icl-rocketry/Ricardo-Heimdall/README.md

Need to add v monitoring to include the buck stuff from chad
Need to add 6v led to know when servo voltage is on
