icl-rocketry/Ricardo-Heimdall/Hardware/Heimdall.kicad_pcb

## KiCad design Hardware/Heimdall.kicad_pcb (2026-07-14)

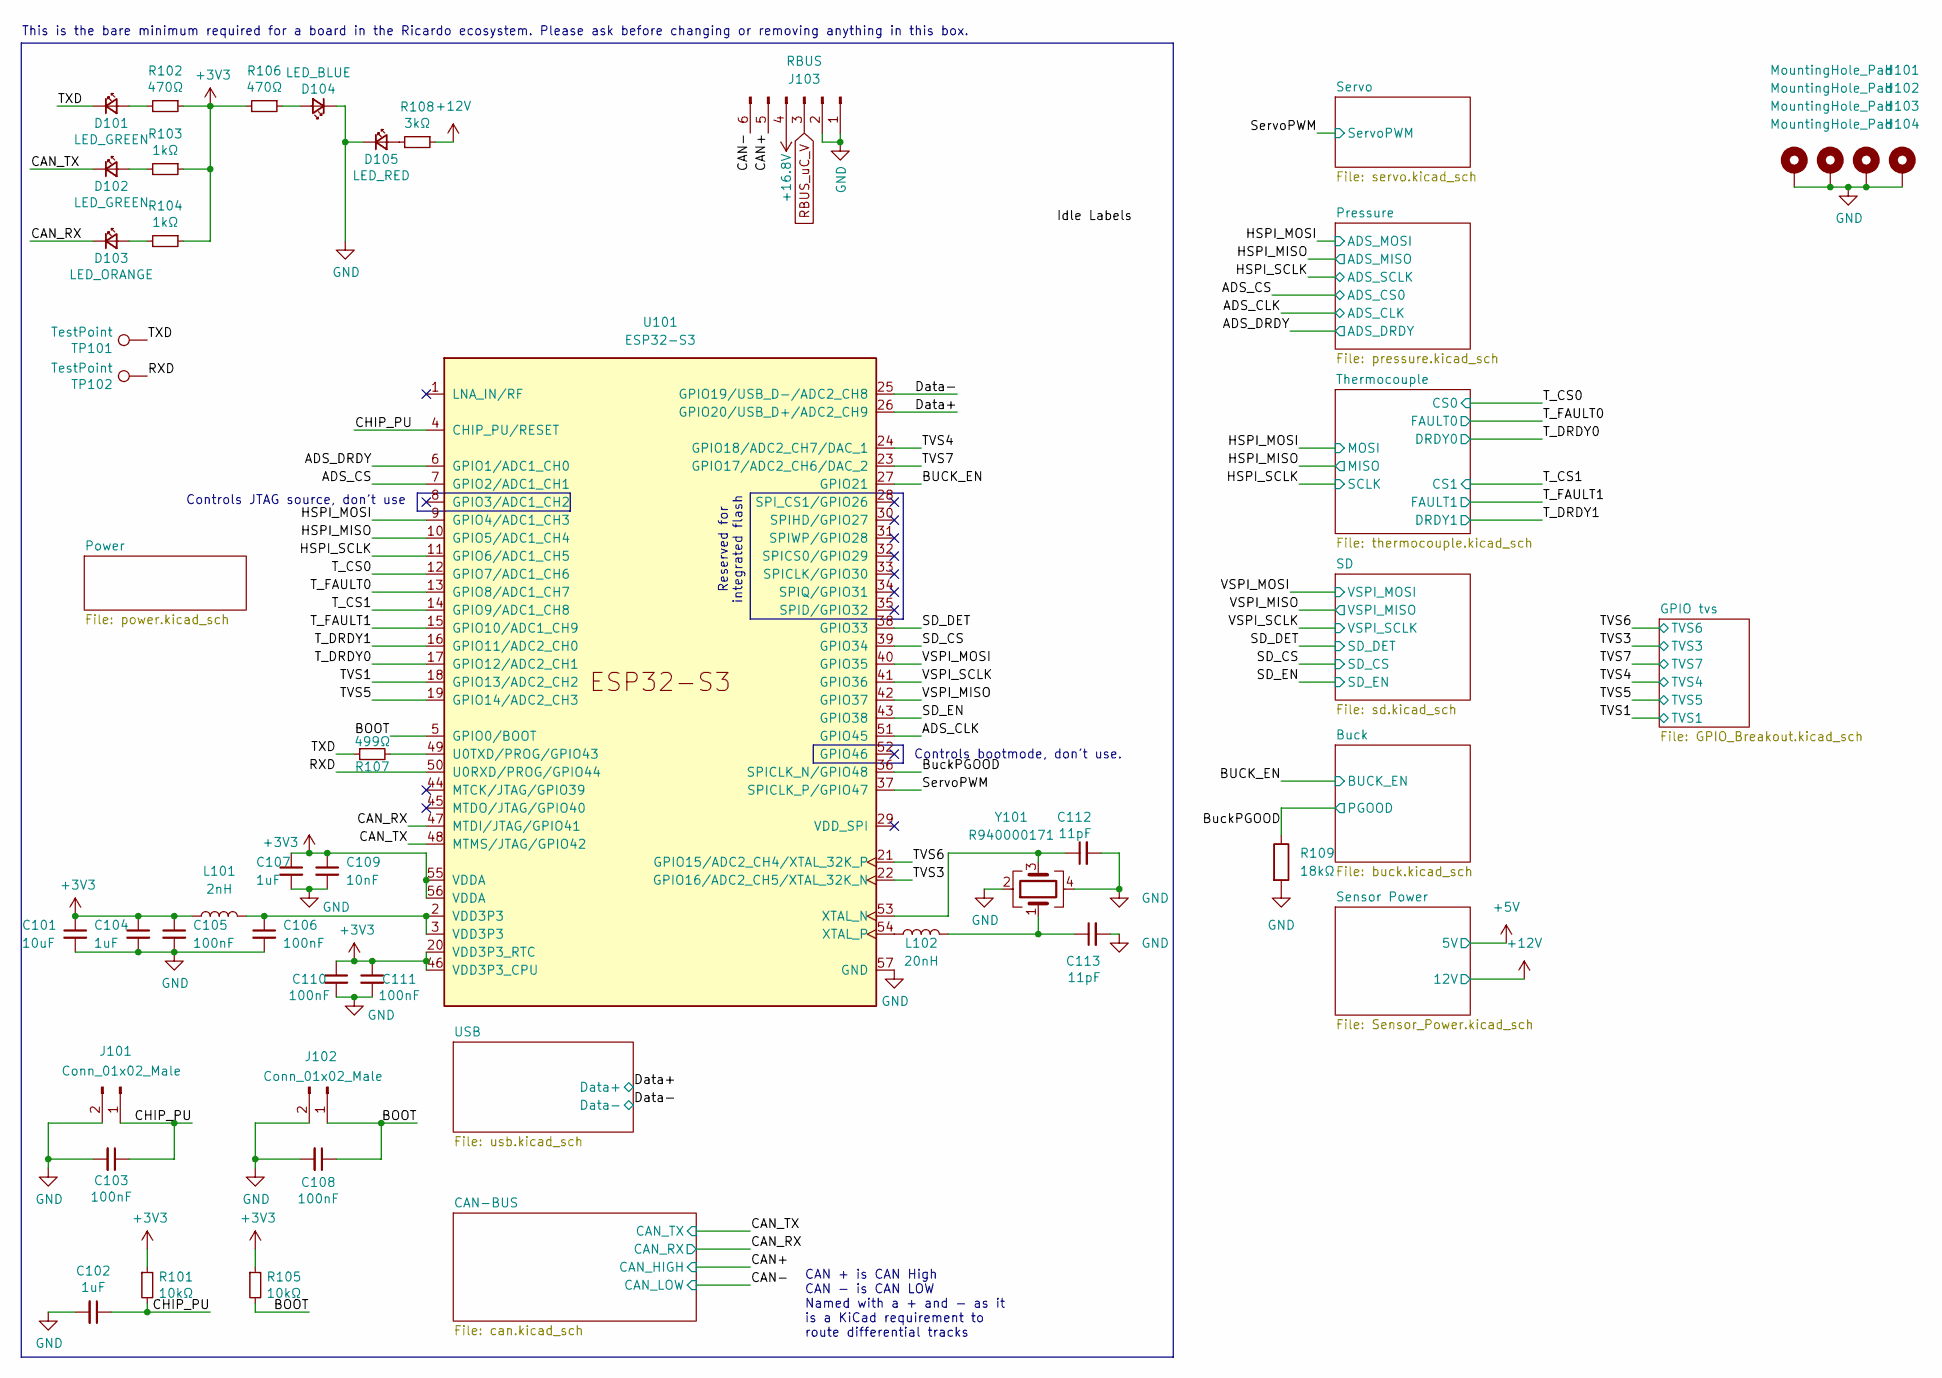
[picture p1: schematic Heimdall.kicad_sch]

Parts:
C101: 10uF; C_0402_1005Metric
C102, C104, C107: 1uF; C_0402_1005Metric
C103, C105, C106, C108, C110, C111: 100nF; C_0402_1005Metric
C109: 10nF; C_0402_1005Metric
C112, C113: 11pF; C_0402_1005Metric
D101, D102: LED_GREEN; LED_0402_1005Metric
D103: LED_ORANGE; LED_0402_1005Metric
D104: LED_BLUE; LED_0402_1005Metric
D105: LED_RED; LED_0402_1005Metric
H101, H102, H103, H104: MountingHole_Pad; MountingHole_3.2mm_M3_DIN965_Pad
J101, J102: Conn_01x02_Male; PinHeader_1x02_P2.54mm_Vertical
J103: RBUS; Molex_Mini-Fit_Jr_5569-06A2_2x03_P4.20mm_Horizontal
L101: 2nH; L_0402_1005Metric
L102: 20nH; L_0402_1005Metric
R101, R105: 10kΩ; R_0402_1005Metric
R102, R106: 470Ω; R_0402_1005Metric
R103, R104: 1kΩ; R_0402_1005Metric
R107: 499Ω; R_0402_1005Metric
R108: 3kΩ; R_0402_1005Metric
R109: 18kΩ; R_0402_1005Metric
TP101, TP102: TestPoint; TestPoint_Pad_D1.0mm
U101: ESP32-S3; QFN40P700X700X90-57N
Y101: R940000171; Crystal_SMD_2016-4Pin_2.0x1.6mm

Connections:
+3V3: C101.1, C104.1, C105.1, C107.1, C109.1, C110.1, C111.1, L101.1, R101.1, R102.1, R103.1, R104.1, R105.1, R106.2, U101.20 (VDD3P3_RTC), U101.46 (VDD3P3_CPU), U101.55 (VDDA), U101.56 (VDDA); also elsewhere on the board
+12V: R108.1; also elsewhere on the board
+16.8V: J103.4; also elsewhere on the board
/ADS_CLK: U101.51 (GPIO45); also elsewhere on the board
/ADS_CS: U101.7 (GPIO2/ADC1_CH1); also elsewhere on the board
/ADS_DRDY: U101.6 (GPIO1/ADC1_CH0); also elsewhere on the board
/BOOT: C108.1, J102.1, R105.2, U101.5 (GPIO0/BOOT)
/BUCK_EN: U101.27 (GPIO21); also elsewhere on the board
/BuckPGOOD: R109.1, U101.36 (SPICLK_N/GPIO48); also elsewhere on the board
/CAN+: J103.5; also elsewhere on the board
/CAN-: J103.6; also elsewhere on the board
/CAN_RX: D103.1 (K), U101.47 (MTDI/JTAG/GPIO41); also elsewhere on the board
/CAN_TX: D102.1 (K), U101.48 (MTMS/JTAG/GPIO42); also elsewhere on the board
/CHIP_PU: C102.1, C103.1, J101.1, R101.2, U101.4 (CHIP_PU/RESET)
/Data+: U101.26 (GPIO20/USB_D+/ADC2_CH9); also elsewhere on the board
/Data-: U101.25 (GPIO19/USB_D-/ADC2_CH8); also elsewhere on the board
/HSPI_MISO: U101.10 (GPIO5/ADC1_CH4); also elsewhere on the board
/HSPI_MOSI: U101.9 (GPIO4/ADC1_CH3); also elsewhere on the board
/HSPI_SCLK: U101.11 (GPIO6/ADC1_CH5); also elsewhere on the board
/RXD: TP102.1, U101.50 (U0RXD/PROG/GPIO44)
/SD_CS: U101.39 (GPIO34); also elsewhere on the board
/SD_DET: U101.38 (GPIO33); also elsewhere on the board
/SD_EN: U101.43 (GPIO38); also elsewhere on the board
/ServoPWM: U101.37 (SPICLK_P/GPIO47); also elsewhere on the board
/TVS1: U101.18 (GPIO13/ADC2_CH2); also elsewhere on the board
/TVS3: U101.22 (GPIO16/ADC2_CH5/XTAL_32K_N); also elsewhere on the board
/TVS4: U101.24 (GPIO18/ADC2_CH7/DAC_1); also elsewhere on the board
/TVS5: U101.19 (GPIO14/ADC2_CH3); also elsewhere on the board
/TVS6: U101.21 (GPIO15/ADC2_CH4/XTAL_32K_P); also elsewhere on the board
/TVS7: U101.23 (GPIO17/ADC2_CH6/DAC_2); also elsewhere on the board
/TXD: D101.1 (K), R107.1, TP101.1
/T_CS0: U101.12 (GPIO7/ADC1_CH6); also elsewhere on the board
/T_CS1: U101.14 (GPIO9/ADC1_CH8); also elsewhere on the board
/T_DRDY0: U101.17 (GPIO12/ADC2_CH1); also elsewhere on the board
/T_DRDY1: U101.16 (GPIO11/ADC2_CH0); also elsewhere on the board
/T_FAULT0: U101.13 (GPIO8/ADC1_CH7); also elsewhere on the board
/T_FAULT1: U101.15 (GPIO10/ADC1_CH9); also elsewhere on the board
/VSPI_MISO: U101.42 (GPIO37); also elsewhere on the board
/VSPI_MOSI: U101.40 (GPIO35); also elsewhere on the board
/VSPI_SCLK: U101.41 (GPIO36); also elsewhere on the board
GND: C101.2, C102.2, C103.2, C104.2, C105.2, C106.2, C107.2, C108.2, C109.2, C110.2, C111.2, C112.2, C113.2, D104.1 (K), D105.1 (K), H101.1, H102.1, H103.1, H104.1, J101.2, J102.2, J103.1, J103.2, R109.2, U101.57 (GND), Y101.2, Y101.4; also elsewhere on the board
unnamed: C106.1, L101.2, U101.2 (VDD3P3), U101.3 (VDD3P3)
unnamed: C113.1, L102.2, Y101.1
unnamed: D101.2 (A), R102.2
unnamed: D102.2 (A), R103.2
unnamed: D103.2 (A), R104.2
unnamed: D104.2 (A), R106.1
unnamed: D105.2 (A), R108.2
unnamed: R107.2, U101.49 (U0TXD/PROG/GPIO43)
unnamed: C112.1, U101.53 (XTAL_N), Y101.3
unnamed: L102.1, U101.54 (XTAL_P)
RBUS_uC_V: J103.3; also elsewhere on the board

Notes on the sheet:
Controls bootmode, don't use.
This is the bare minimum required for a board in the Ricardo ecosystem. Please ask before changing or removing anything in this box.
CAN + is CAN High CAN - is CAN LOW Named with a + and - as it is a KiCad requirement to route differential tracks
Controls JTAG source, don't use
Reserved for integrated flash

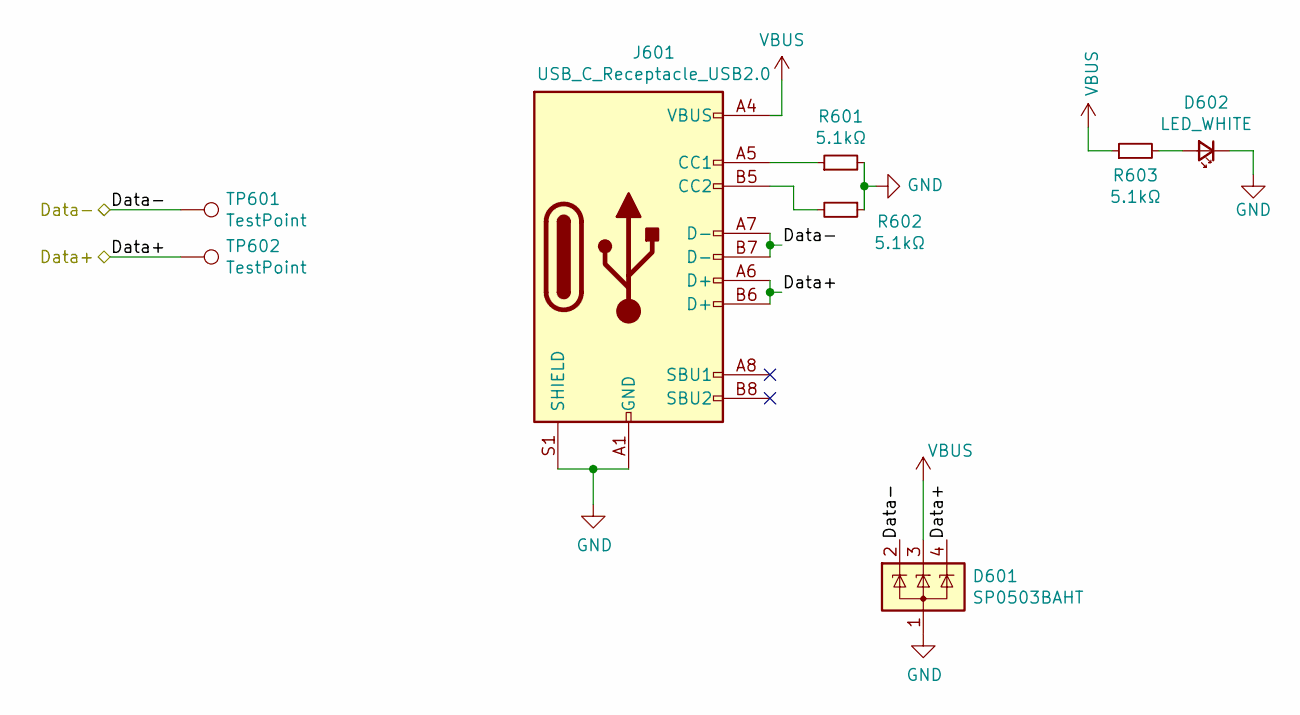
[picture p2: schematic usb.kicad_sch]

Parts:
D601: SP0503BAHT; SOT-143
D602: LED_WHITE; LED_0402_1005Metric
J601: USB_C_Receptacle_USB2.0; USB_C_Receptacle_Palconn_UTC16-G
R601, R602, R603: 5.1kΩ; R_0402_1005Metric
TP601, TP602: TestPoint; TestPoint_Pad_D1.0mm

Connections:
/Data+: D601.4 (K), J601.A6 (D+), J601.B6 (D+), TP602.1; also elsewhere on the board
/Data-: D601.2 (K), J601.A7 (D-), J601.B7 (D-), TP601.1; also elsewhere on the board
GND: D601.1 (A), D602.1 (K), J601.A1 (GND), J601.A12 (GND), J601.B1 (GND), J601.B12 (GND), J601.S1 (SHIELD), R601.2, R602.1; also elsewhere on the board
unnamed: D602.2 (A), R603.2
unnamed: J601.A5 (CC1), R601.1
unnamed: J601.B5 (CC2), R602.2
VBUS: D601.3 (K), J601.A4 (VBUS), J601.A9 (VBUS), J601.B4 (VBUS), J601.B9 (VBUS), R603.1; also elsewhere on the board

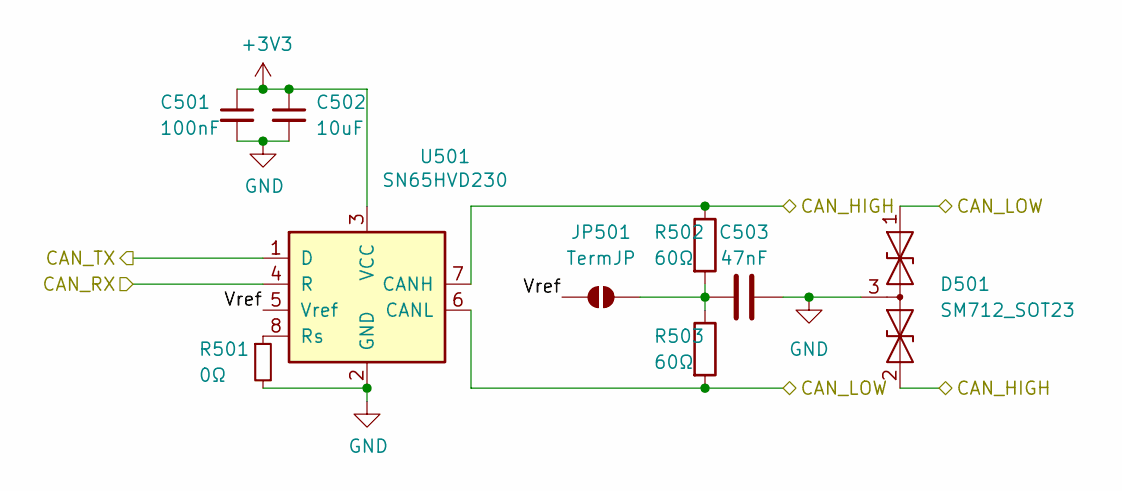
[picture p3: schematic can.kicad_sch]

Parts:
C501: 100nF; C_0402_1005Metric
C502: 10uF; C_0402_1005Metric
C503: 47nF; C_0402_1005Metric
D501: SM712_SOT23; SOT-23
JP501: TermJP; SmallerSolderJP
R501: 0Ω; R_0402_1005Metric
R502, R503: 60Ω; R_0603_1608Metric
U501: SN65HVD230; SOIC-8_3.9x4.9mm_P1.27mm

Connections:
+3V3: C501.1, C502.1, U501.3 (VCC); also elsewhere on the board
/CAN+: D501.2 (A2), R502.1, U501.7 (CANH); also elsewhere on the board
/CAN-: D501.1 (A1), R503.2, U501.6 (CANL); also elsewhere on the board
/CAN-BUS/Vref: JP501.1 (A), U501.5 (Vref)
/CAN_RX: U501.4 (R); also elsewhere on the board
/CAN_TX: U501.1 (D); also elsewhere on the board
GND: C501.2, C502.2, C503.2, D501.3 (common), R501.2, U501.2 (GND); also elsewhere on the board
unnamed: C503.1, JP501.2 (B), R502.2, R503.1
unnamed: R501.1, U501.8 (Rs)

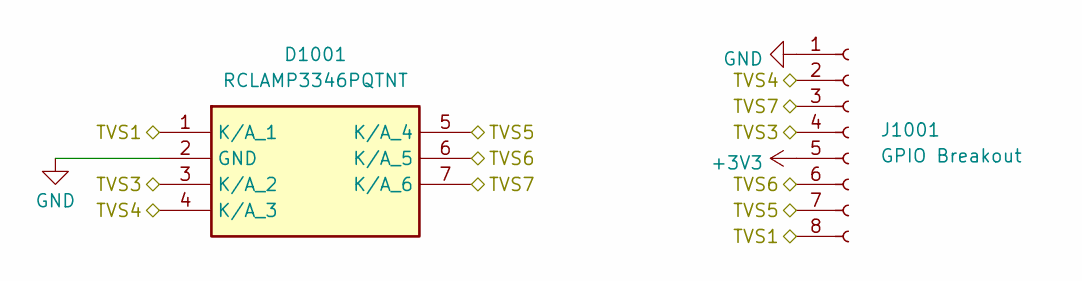
[picture p4: schematic GPIO_Breakout.kicad_sch]

Parts:
D1001: RCLAMP3346PQTNT; Mouser Part Number 947-RCLAMP3346PQTNT
J1001: GPIO Breakout; PinSocket_2x04_P2.54mm_Vertical

Connections:
+3V3: J1001.5; also elsewhere on the board
/TVS1: D1001.1 (K/A_1), J1001.8; also elsewhere on the board
/TVS3: D1001.3 (K/A_2), J1001.4; also elsewhere on the board
/TVS4: D1001.4 (K/A_3), J1001.2; also elsewhere on the board
/TVS5: D1001.5 (K/A_4), J1001.7; also elsewhere on the board
/TVS6: D1001.6 (K/A_5), J1001.6; also elsewhere on the board
/TVS7: D1001.7 (K/A_6), J1001.3; also elsewhere on the board
GND: D1001.2 (GND), J1001.1; also elsewhere on the board

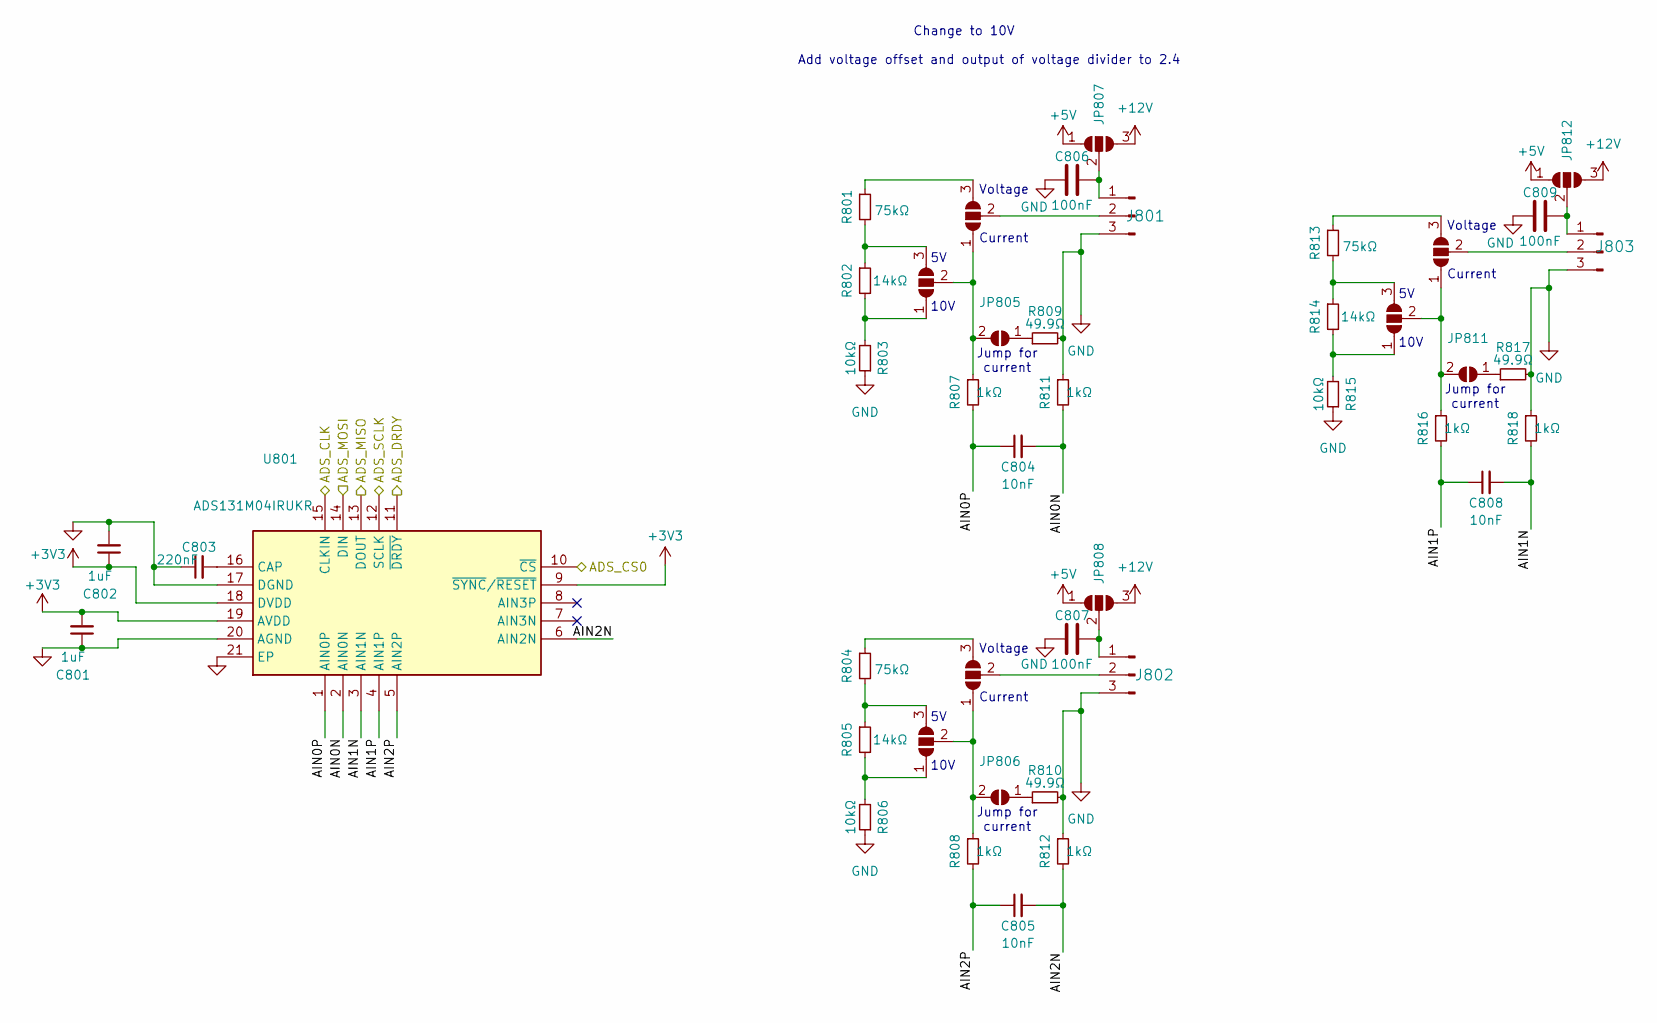
[picture p5: schematic pressure.kicad_sch]

Parts:
C801, C802: 1uF; C_0402_1005Metric
C803: 220nF; C_0402_1005Metric
C804, C805, C808: 10nF; C_0402_1005Metric
C806, C807, C809: 100nF; C_0402_1005Metric
J801, J802, J803: 1053131103; Molex_Nano-Fit_105313-xx03_1x03_P2.50mm_Horizontal
JP801, JP802, JP803, JP804, JP807, JP808, JP809, JP810, JP812: SolderJumper_3_Open; SolderJumper-3_P1.3mm_Open_RoundedPad1.0x1.5mm_NumberLabels
JP805, JP806, JP811: SolderJumper_2_Open; SmallerSolderJP
R801, R804, R813: 75kΩ; R_0402_1005Metric; MPN RT0402BRD0775KL
R802, R805, R814: 14kΩ; R_0402_1005Metric; MPN 0402WGF1402TCE
R803, R806, R815: 10kΩ; R_0402_1005Metric; MPN ERA2ARB103X
R807, R808, R811, R812, R816, R818: 1kΩ; R_0402_1005Metric
R809, R810, R817: 49.9Ω; R_0402_1005Metric; MPN RT0402BRD0749R9L
U801: ADS131M04IRUKR; QFN40P300X300X80-21N-D; Manufacturer_Part_Number ADS131M04IRUKR; Mouser Part Number 595-ADS131M04IRUKR

Connections:
+3V3: C801.2, C802.1, U801.9 (~SYNC/~RESET), U801.18 (DVDD), U801.19 (AVDD); also elsewhere on the board
+5V: JP807.1 (A), JP808.1 (A), JP812.1 (A); also elsewhere on the board
+12V: JP807.3 (B), JP808.3 (B), JP812.3 (B); also elsewhere on the board
/ADS_CLK: U801.15 (CLKIN); also elsewhere on the board
/ADS_CS: U801.10 (~CS); also elsewhere on the board
/ADS_DRDY: U801.11 (~DRDY); also elsewhere on the board
/HSPI_MISO: U801.13 (DOUT); also elsewhere on the board
/HSPI_MOSI: U801.14 (DIN); also elsewhere on the board
/HSPI_SCLK: U801.12 (SCLK); also elsewhere on the board
/Pressure/AIN0N: C804.2, R811.2, U801.2 (AIN0N)
/Pressure/AIN0P: C804.1, R807.2, U801.1 (AIN0P)
/Pressure/AIN1N: C808.2, R818.2, U801.3 (AIN1N)
/Pressure/AIN1P: C808.1, R816.2, U801.4 (AIN1P)
/Pressure/AIN2N: C805.2, R812.2, U801.6 (AIN2N)
/Pressure/AIN2P: C805.1, R808.2, U801.5 (AIN2P)
GND: C801.1, C802.2, C803.1, C806.1, C807.1, C809.1, J801.3, J802.3, J803.3, R803.1, R806.1, R809.2, R810.2, R811.1, R812.1, R815.1, R817.2, R818.1, U801.17 (DGND), U801.20 (AGND), U801.21 (EP); also elsewhere on the board
unnamed: C806.2, J801.1, JP807.2 (C)
unnamed: J801.2, JP803.2 (C)
unnamed: C807.2, J802.1, JP808.2 (C)
unnamed: J802.2, JP804.2 (C)
unnamed: C809.2, J803.1, JP812.2 (C)
unnamed: J803.2, JP810.2 (C)
unnamed: JP801.1 (A), R802.2, R803.2
unnamed: JP801.3 (B), R801.2, R802.1
unnamed: JP801.2 (C), JP803.1 (A), JP805.2 (B), R807.1
unnamed: JP802.1 (A), R805.2, R806.2
unnamed: JP802.3 (B), R804.2, R805.1
unnamed: JP802.2 (C), JP804.1 (A), JP806.2 (B), R808.1
unnamed: JP803.3 (B), R801.1
unnamed: JP804.3 (B), R804.1
unnamed: JP805.1 (A), R809.1
unnamed: JP806.1 (A), R810.1
unnamed: JP809.1 (A), R814.2, R815.2
unnamed: JP809.3 (B), R813.2, R814.1
unnamed: JP809.2 (C), JP810.1 (A), JP811.2 (B), R816.1
unnamed: JP810.3 (B), R813.1
unnamed: JP811.1 (A), R817.1
unnamed: C803.2, U801.16 (CAP)

Notes on the sheet:
Jump for current
10V
Add voltage offset and output of voltage divider to 2.4
Voltage
Change to 10V
Current

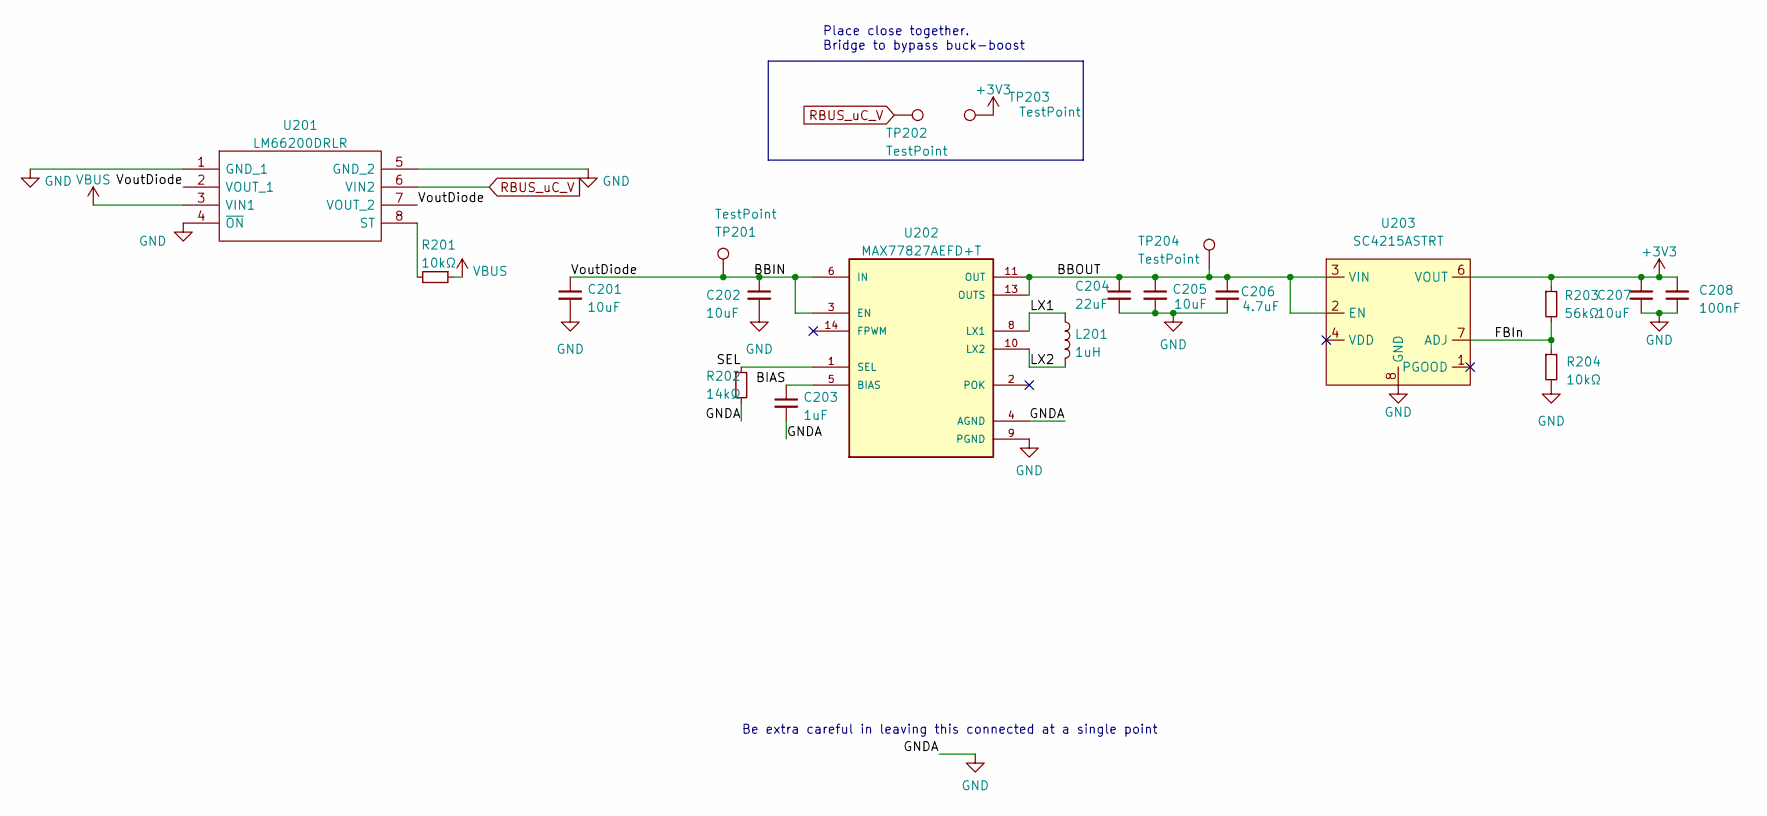
[picture p6: schematic power.kicad_sch]

Parts:
C201, C205, C207: 10uF; C_0402_1005Metric
C202: 10uF; C_0603_1608Metric
C203: 1uF; C_0402_1005Metric
C204: 22uF; C_0603_1608Metric
C206: 4.7uF; C_0402_1005Metric
C208: 100nF; C_0402_1005Metric
L201: 1uH; L_0805_2012Metric
R201, R204: 10kΩ; R_0402_1005Metric
R202: 14kΩ; R_0402_1005Metric
R203: 56kΩ; R_0402_1005Metric
TP201, TP202, TP203, TP204: TestPoint; TestPoint_Pad_D1.5mm
U201: LM66200DRLR; SOTFL50P160X60-8N; Manufacturer_Part_Number LM66200DRLR; Mouser Part Number 595-LM66200DRLR
U202: MAX77827AEFD+T; CONV_MAX77827AEFD+T; PARTREV B
U203: SC4215ASTRT; SOIC127P599X175-9N

Connections:
+3V3: C207.2, C208.2, R203.1, TP203.1, U203.6 (VOUT); also elsewhere on the board
/Power/BBIN: C201.1, C202.1, TP201.1, U201.2 (VOUT_1), U201.7 (VOUT_2), U202.3 (EN), U202.6 (IN)
/Power/BBOUT: C204.1, C205.1, C206.1, TP204.1, U202.11 (OUT), U202.13 (OUTS), U203.2 (EN), U203.3 (VIN)
/Power/BIAS: C203.1, U202.5 (BIAS)
/Power/FBIn: R203.2, R204.1, U203.7 (ADJ)
/Power/LX1: L201.1, U202.8 (LX1)
/Power/LX2: L201.2, U202.10 (LX2)
/Power/SEL: R202.1, U202.1 (SEL)
GND: C201.2, C202.2, C203.2, C204.2, C205.2, C206.2, C207.1, C208.1, R202.2, R204.2, U201.1 (GND_1), U201.4 (~ON), U201.5 (GND_2), U202.4 (AGND), U202.9 (PGND), U203.8 (GND), U203.9 (GND); also elsewhere on the board
unnamed: R201.2, U201.8 (ST)
RBUS_uC_V: TP202.1, U201.6 (VIN2); also elsewhere on the board
VBUS: R201.1, U201.3 (VIN1); also elsewhere on the board

Notes on the sheet:
Place close together. Bridge to bypass buck-boost
Be extra careful in leaving this connected at a single point

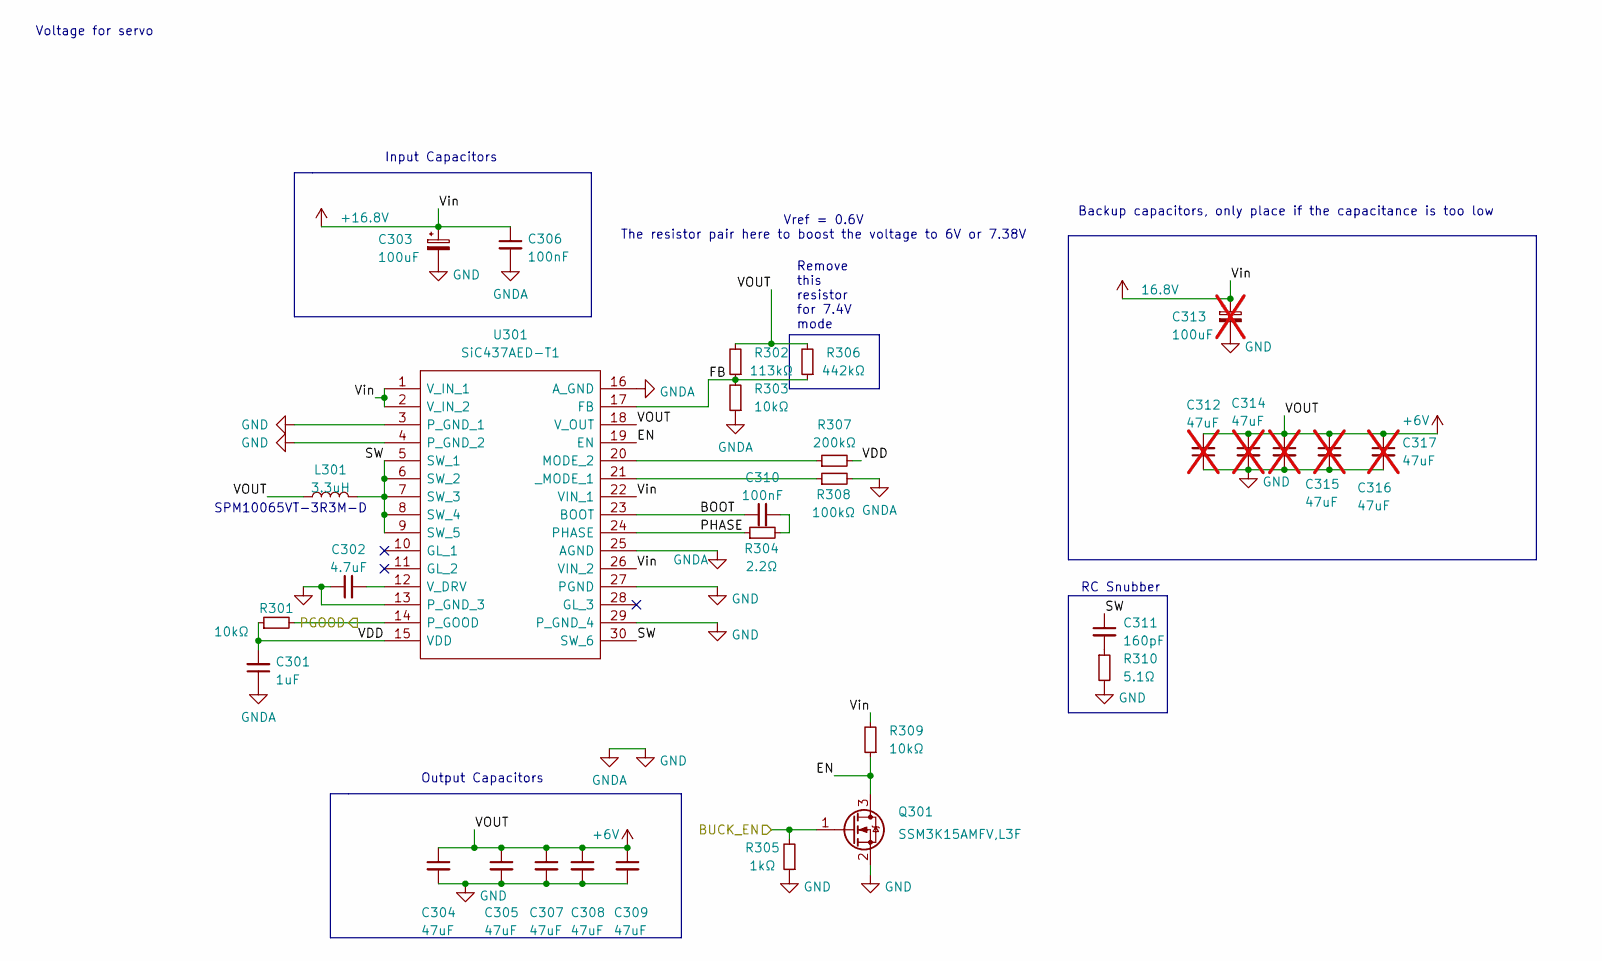
[picture p7: schematic buck.kicad_sch]

Parts:
C301: 1uF; C_0402_1005Metric
C302: 4.7uF; C_0402_1005Metric
C303: 100uF; CP_EIA-7360-38_Kemet-E; MPN T52M1107M035C0100
C304, C305, C307, C308, C309: 47uF; C_1206_3216Metric
C306, C310: 100nF; C_0402_1005Metric
C311: 160pF; C_0603_1608Metric
C312, C314, C315, C316, C317: 47uF; C_1206_3216Metric; not fitted
C313: 100uF; CP_EIA-7360-38_Kemet-E; MPN T52M1107M035C0100; not fitted
L301: 3.3uH; IND_SPM10065VT-3R3M-D; MPN SPM10065VT-3R3M-D
Q301: SSM3K15AMFV,L3F; SOT-723
R301, R303, R309: 10kΩ; R_0402_1005Metric
R302: 113kΩ; R_0402_1005Metric; MPN ERJ-2RKF1133X
R304: 2.2Ω; R_0402_1005Metric
R305: 1kΩ; R_0402_1005Metric
R306: 442kΩ; R_0402_1005Metric; MPN ERJ-2RKF4423X
R307: 200kΩ; R_0402_1005Metric
R308: 100kΩ; R_0402_1005Metric
R310: 5.1Ω; R_0603_1608Metric
U301: SiC437AED-T1; SiC437BEDT1GE3; Manufacturer_Part_Number SiC437BED-T1-GE3; Mouser Part Number 78-SIC437BED-T1-GE3

Connections:
+6V: C304.1, C305.1, C307.1, C308.1, C309.1, C312.2, C314.1, C315.1, C316.1, C317.1, L301.1, R302.2, R306.2, U301.18 (V_OUT); also elsewhere on the board
+16.8V: C303.1, C306.1, C313.1, R309.2, U301.1 (V_IN_1), U301.2 (V_IN_2), U301.22 (VIN_1), U301.26 (VIN_2); also elsewhere on the board
/BUCK_EN: Q301.1 (G), R305.2; also elsewhere on the board
/Buck/BOOT: C310.1, U301.23 (BOOT)
/Buck/EN: Q301.3 (D), R309.1, U301.19 (EN)
/Buck/FB: R302.1, R303.2, R306.1, U301.17 (FB)
/Buck/PHASE: R304.1, U301.24 (PHASE)
/Buck/SW: C311.1, L301.2, U301.5 (SW_1), U301.6 (SW_2), U301.7 (SW_3), U301.8 (SW_4), U301.9 (SW_5), U301.30 (SW_6)
/Buck/VDD: C301.2, R301.1, R307.2, U301.15 (VDD)
/BuckPGOOD: R301.2, U301.14 (P_GOOD); also elsewhere on the board
GND: C301.1, C302.1, C303.2, C304.2, C305.2, C306.2, C307.2, C308.2, C309.2, C312.1, C313.2, C314.2, C315.2, C316.2, C317.2, Q301.2 (S), R303.1, R305.1, R308.2, R310.2, U301.3 (P_GND_1), U301.4 (P_GND_2), U301.13 (P_GND_3), U301.16 (A_GND), U301.25 (AGND), U301.27 (PGND), U301.29 (P_GND_4); also elsewhere on the board
unnamed: C310.2, R304.2
unnamed: C311.2, R310.1
unnamed: R307.1, U301.20 (MODE_2)
unnamed: C302.2, U301.12 (V_DRV)
unnamed: R308.1, U301.21 (_MODE_1)

Notes on the sheet:
SPM10065VT-3R3M-D
Voltage for servo
Output Capacitors
Backup capacitors, only place if the capacitance is too low
Input Capacitors
Vref = 0.6V The resistor pair here to boost the voltage to 6V or 7.38V
RC Snubber
Remove this resistor for 7.4V mode

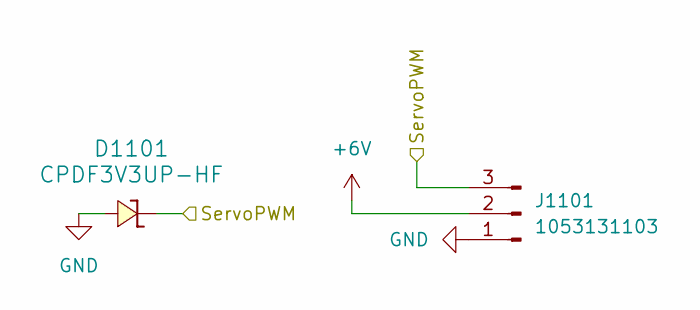
[picture p8: schematic servo.kicad_sch]

Parts:
D1101: CPDF3V3UP-HF; CPD
J1101: 1053131103; Molex_Nano-Fit_105313-xx03_1x03_P2.50mm_Horizontal

Connections:
+6V: J1101.2; also elsewhere on the board
/ServoPWM: D1101.2, J1101.3; also elsewhere on the board
GND: D1101.1, J1101.1; also elsewhere on the board

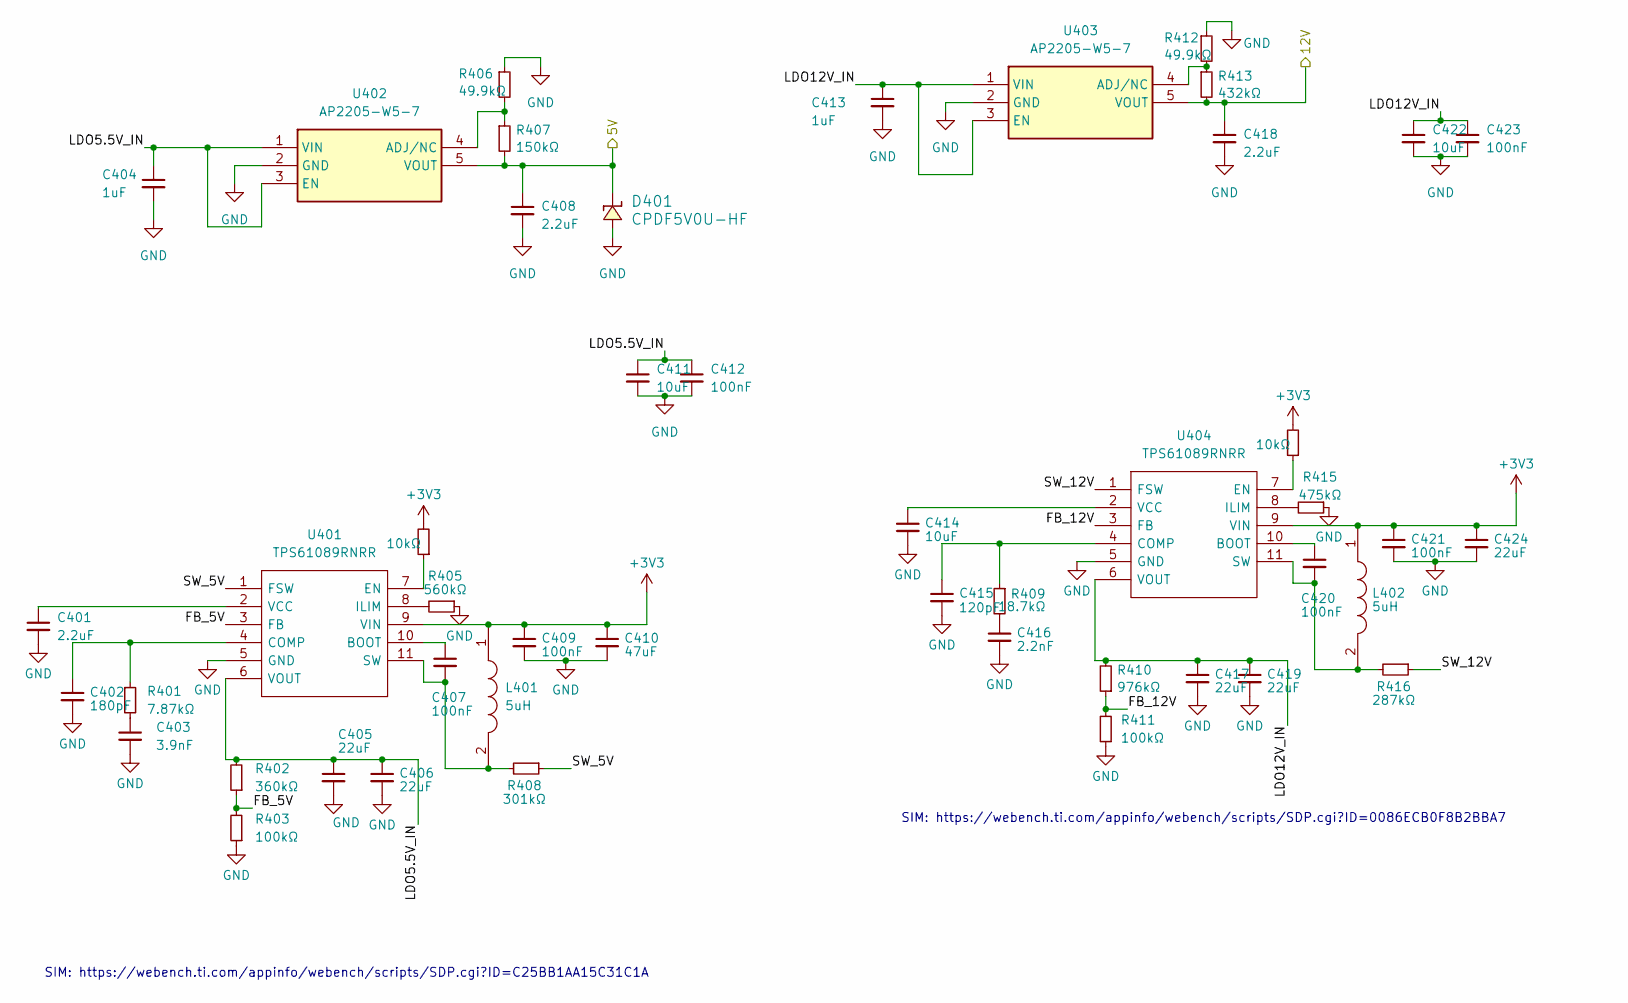
[picture p9: schematic Sensor_Power.kicad_sch]

Parts:
C401: 2.2uF; C_0603_1608Metric
C402: 180pF; C_0402_1005Metric
C403: 3.9nF; C_0402_1005Metric
C404, C413: 1uF; C_0402_1005Metric; MPN CL05X105KA5NQNC
C405, C406, C417, C419: 22uF; C_0805_2012Metric
C407, C409, C420, C421: 100nF; C_0402_1005Metric
C408, C418: 2.2uF; C_0402_1005Metric; MPN GRM155R61E225ME15D
C410: 47uF; C_1206_3216Metric
C411, C422: 10uF; C_0603_1608Metric; MPN TMK107BBJ106MA-T
C412, C423: 100nF; C_0402_1005Metric; MPN C1005X5R1E104KT000E
C414: 10uF; C_0603_1608Metric
C415: 120pF; C_0402_1005Metric
C416: 2.2nF; C_0402_1005Metric
C424: 22uF; C_1206_3216Metric
D401: CPDF5V0U-HF; CPD
L401, L402: 5uH; IND_SRP6540-390M; Manufacturer_Part_Number SRR6038-5R0Y; Mouser Part Number 652-SRR6038-5R0Y
R401: 7.87kΩ; R_0402_1005Metric
R402: 360kΩ; R_0402_1005Metric
R403, R411: 100kΩ; R_0402_1005Metric
R404, R414: 10kΩ; R_0402_1005Metric
R405: 560kΩ; R_0402_1005Metric
R406, R412: 49.9kΩ; R_0402_1005Metric
R407: 150kΩ; R_0603_1608Metric
R408: 301kΩ; R_0402_1005Metric
R409: 18.7kΩ; R_0402_1005Metric
R410: 976kΩ; R_0402_1005Metric
R413: 432kΩ; R_0402_1005Metric
R415: 475kΩ; R_0402_1005Metric
R416: 287kΩ; R_0402_1005Metric
U401, U404: TPS61089RNRR; IC_TPS61089RNRR; Manufacturer_Part_Number TPS61089RNRR; Mouser Part Number 595-TPS61089RNRR
U402, U403: AP2205-W5-7; SOT95P282X145-5N; Mouser Part Number 621-AP2205-W5-7

Connections:
+3V3: C409.1, C410.1, C421.1, C424.1, L401.1, L402.1, R404.2, R414.2, U401.9 (VIN), U404.9 (VIN); also elsewhere on the board
+5V: C408.1, D401.2, R407.2, U402.5 (VOUT); also elsewhere on the board
+12V: C418.1, R413.2, U403.5 (VOUT); also elsewhere on the board
/Sensor Power/FB_5V: R402.1, R403.2, U401.3 (FB)
/Sensor Power/FB_12V: R410.1, R411.2, U404.3 (FB)
/Sensor Power/LDO5.5V_IN: C404.1, C405.1, C406.1, C411.1, C412.1, R402.2, U401.6 (VOUT), U402.1 (VIN), U402.3 (EN)
/Sensor Power/LDO12V_IN: C413.1, C417.1, C419.1, C422.1, C423.1, R410.2, U403.1 (VIN), U403.3 (EN), U404.6 (VOUT)
/Sensor Power/SW_5V: R408.1, U401.1 (FSW)
/Sensor Power/SW_12V: R416.1, U404.1 (FSW)
GND: C401.2, C402.2, C403.2, C404.2, C405.2, C406.2, C408.2, C409.2, C410.2, C411.2, C412.2, C413.2, C414.2, C415.2, C416.2, C417.2, C418.2, C419.2, C421.2, C422.2, C423.2, C424.2, D401.1, R403.1, R405.1, R406.1, R411.1, R412.1, R415.1, U401.5 (GND), U402.2 (GND), U403.2 (GND), U404.5 (GND); also elsewhere on the board
unnamed: C403.1, R401.2
unnamed: C416.1, R409.2
unnamed: C407.1, U401.10 (BOOT)
unnamed: C402.1, R401.1, U401.4 (COMP)
unnamed: R404.1, U401.7 (EN)
unnamed: R405.2, U401.8 (ILIM)
unnamed: C407.2, L401.2, R408.2, U401.11 (SW)
unnamed: C401.1, U401.2 (VCC)
unnamed: R406.2, R407.1, U402.4 (ADJ/NC)
unnamed: R412.2, R413.1, U403.4 (ADJ/NC)
unnamed: C420.1, U404.10 (BOOT)
unnamed: C415.1, R409.1, U404.4 (COMP)
unnamed: R414.1, U404.7 (EN)
unnamed: R415.2, U404.8 (ILIM)
unnamed: C420.2, L402.2, R416.2, U404.11 (SW)
unnamed: C414.1, U404.2 (VCC)

Notes on the sheet:
SIM: https://webench.ti.com/appinfo/webench/scripts/SDP.cgi?ID=0086ECB0F8B2BBA7
SIM: https://webench.ti.com/appinfo/webench/scripts/SDP.cgi?ID=C25BB1AA15C31C1A

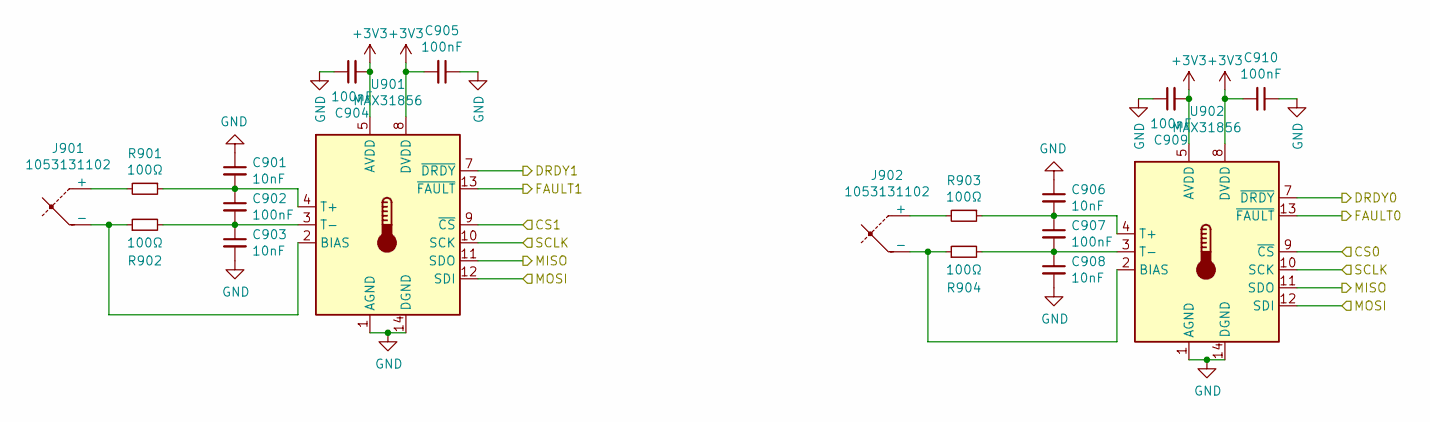
[picture p10: schematic thermocouple.kicad_sch]

Parts:
C901, C903, C906, C908: 10nF; C_0402_1005Metric
C902, C904, C905, C907, C909, C910: 100nF; C_0402_1005Metric
J901, J902: 1053131102; Molex_Nano-Fit_105313-xx02_1x02_P2.50mm_Horizontal
R901, R902, R903, R904: 100Ω; R_0402_1005Metric
U901, U902: MAX31856; TSSOP-14_4.4x5mm_P0.65mm

Connections:
+3V3: C904.2, C905.2, C909.2, C910.2, U901.5 (AVDD), U901.8 (DVDD), U902.5 (AVDD), U902.8 (DVDD); also elsewhere on the board
/HSPI_MISO: U901.11 (SDO), U902.11 (SDO); also elsewhere on the board
/HSPI_MOSI: U901.12 (SDI), U902.12 (SDI); also elsewhere on the board
/HSPI_SCLK: U901.10 (SCK), U902.10 (SCK); also elsewhere on the board
/T_CS0: U902.9 (~CS); also elsewhere on the board
/T_CS1: U901.9 (~CS); also elsewhere on the board
/T_DRDY0: U902.7 (~DRDY); also elsewhere on the board
/T_DRDY1: U901.7 (~DRDY); also elsewhere on the board
/T_FAULT0: U902.13 (~FAULT); also elsewhere on the board
/T_FAULT1: U901.13 (~FAULT); also elsewhere on the board
GND: C901.1, C903.2, C904.1, C905.1, C906.1, C908.2, C909.1, C910.1, U901.1 (AGND), U901.14 (DGND), U902.1 (AGND), U902.14 (DGND); also elsewhere on the board
unnamed: J901.1 (+), R901.2
unnamed: J901.2 (-), R902.1, U901.2 (BIAS)
unnamed: J902.1 (+), R903.2
unnamed: J902.2 (-), R904.1, U902.2 (BIAS)
unnamed: C901.2, C902.1, R901.1, U901.4 (T+)
unnamed: C902.2, C903.1, R902.2, U901.3 (T-)
unnamed: C906.2, C907.1, R903.1, U902.4 (T+)
unnamed: C907.2, C908.1, R904.2, U902.3 (T-)
