icl-rocketry/Ricardo-Heimdall/Hardware/Heimdall.kicad_pcb

## KiCad design Hardware/Heimdall.kicad_pcb (continued)

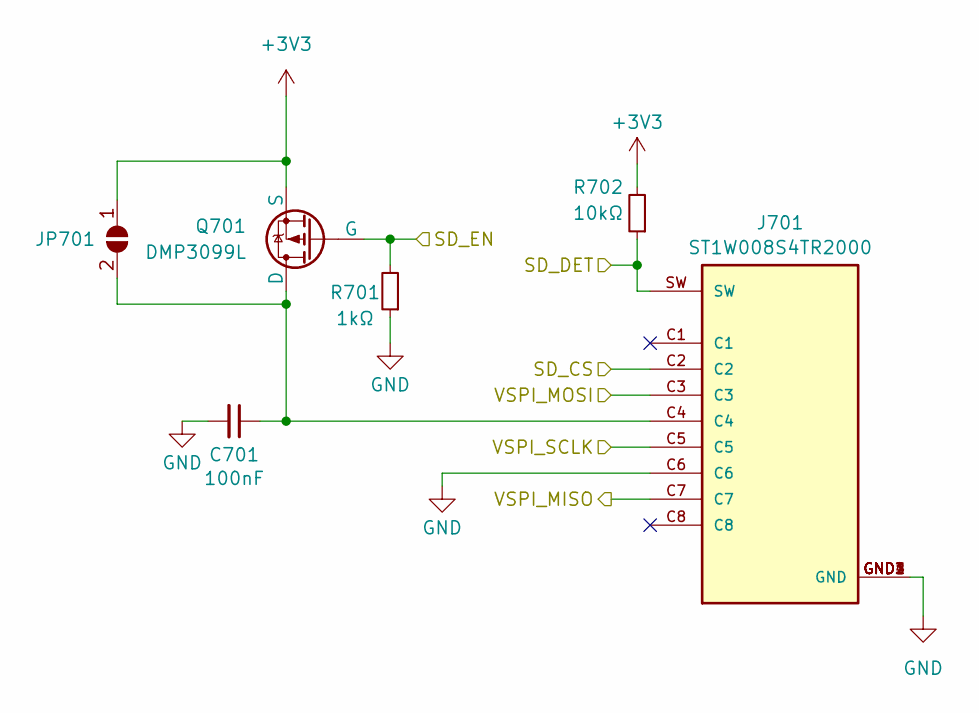
[picture p11: schematic sd.kicad_sch]

Parts:
C701: 100nF; C_0402_1005Metric
J701: ST1W008S4TR2000; JAE_ST1W008S4TR2000; PARTREV 1
JP701: SolderJumper_2_Open; SmallerSolderJP
Q701: DMP3099L; SOT-23; MPN DMP3099L
R701: 1kΩ; R_0402_1005Metric
R702: 10kΩ; R_0402_1005Metric

Connections:
+3V3: JP701.1 (A), Q701.3 (S), R702.2; also elsewhere on the board
/SD_CS: J701.C2; also elsewhere on the board
/SD_DET: J701.SW, R702.1; also elsewhere on the board
/SD_EN: Q701.2 (G), R701.2; also elsewhere on the board
/VSPI_MISO: J701.C7; also elsewhere on the board
/VSPI_MOSI: J701.C3; also elsewhere on the board
/VSPI_SCLK: J701.C5; also elsewhere on the board
GND: C701.2, J701.C6, J701.GND1 (GND), J701.GND2 (GND), J701.GND3 (GND), J701.GND4 (GND), R701.1; also elsewhere on the board
unnamed: C701.1, J701.C4, JP701.2 (B), Q701.1 (D)

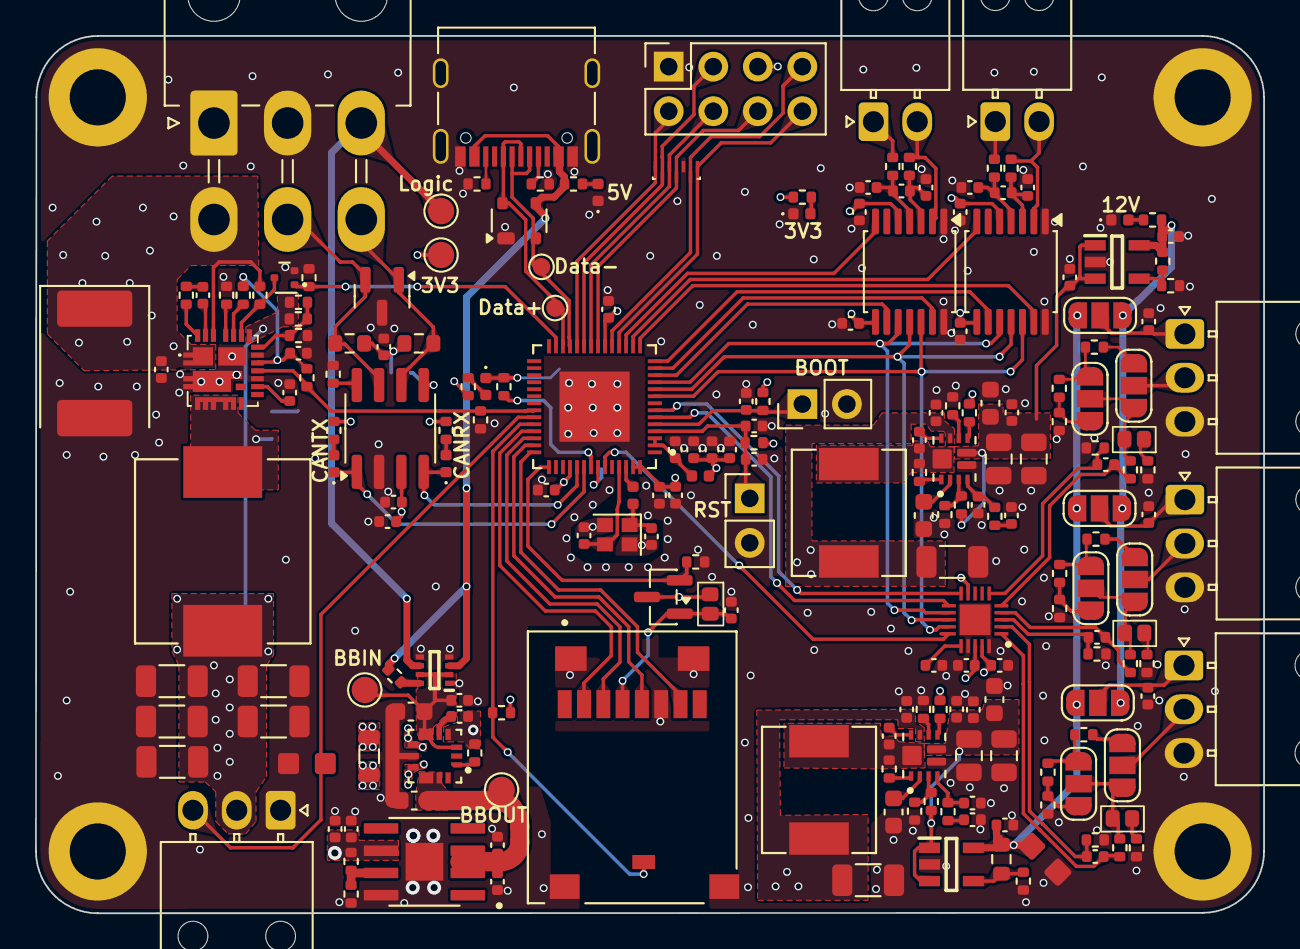
[picture p12: board Heimdall.kicad_pcb from above]

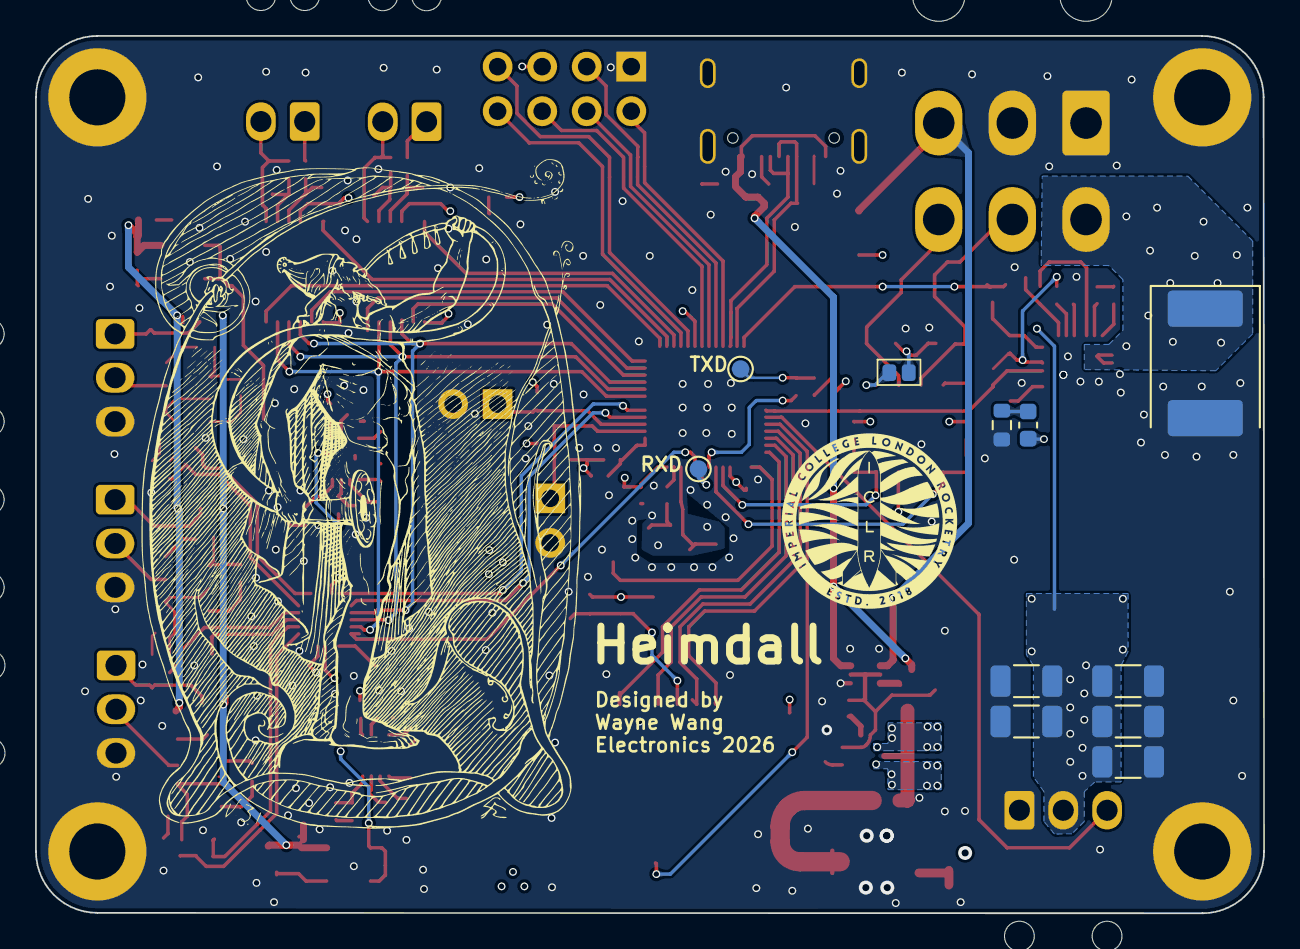
[picture p13: board Heimdall.kicad_pcb from below]

Board: 4 copper layers, 70.0 x 50.0 mm, 226 parts (12 on the bottom side), 139 nets.

Other parts of the board:
LOGO1: ICLR LOGO; iclr_logo_estd2018_10mm
