icl-rocketry/Ricardo-Heimdall/Firmware/src/system.h

#pragma once

#include <libriccore/riccoresystem.h>

#include "Config/systemflags_config.h"
#include "Config/commands_config.h"
#include "Config/pinmap_config.h"

#include <libriccore/networkinterfaces/can/canbus.h>

// #include <libriccore/drivers/adc/ADS131M06.h>
#include <libriccore/drivers/adc/ADS131M04.h>
#include <libriccore/drivers/sensors/MAX31856.h>
#include <librrc/Remote/nrcremoteptap.h>
#include <librrc/Remote/nrcremoteloadcell.h>
#include <librrc/Remote/nrcremoteflowsensor.h>
#include "SiC43x.h"
#include <nrcgreg/nrcgreg.h>

#include "Commands/commands.h"

#include "Storage/sdfat_store.h"

/* System class: a class which encapsulates all the classes used to describe components on
    the board, creating the board system. Interacting with the board involves interacting
    the system */

class System : public RicCoreSystem<System,SYSTEM_FLAG,Commands::ID>
{
    public:

        System();

        void systemSetup();

        void systemUpdate();

        CanBus<SYSTEM_FLAG> canbus;

        //2 seperate SPI lines:
        SPIClass SDSPI;     //SPI for the SD card
        SPIClass SNSRSPI;   //SPI for the sensors
        //2 thermocouples:
        MAX31856 TC0;
        // MAX31856 TC1;
        //1 4-channel ADC:
        ADS131M04 ADC0;

        //Pressure Sensors
        NRCRemotePTap FB_PT;
        NRCRemotePTap N2_PT;

        SiC43x Buck;

        //Greg
        NRCGreg Heimdall;

        //SD Card
        SdFat_Store primarysd;

    private:

        void setupSPI();
        void serviceSetup();
        void deviceUpdate();
        void remoteSensorUpdate();
        void initializeLoggers();
        void logReadings();
        void remoteSensorSetup();

        const std::string log_path = "/Logs";
        const std::string config_path = "/Config";

        static constexpr uint8_t fb_pt_adc_ch = 0;
        static constexpr uint8_t n2_pt_adc_ch = 2;

        uint32_t telemetry_log_delta = 1000;
        uint32_t prev_telemetry_log_time;
};
