icl-rocketry/Ricardo-Heimdall/(commit log)

2026-01-13 Updated connections
    [Reggie.kicad_sch, pressure.kicad_sch]
2026-01-20 new TVS
    [Reggie.kicad_pcb, Reggie.kicad_sch, buck.kicad_sch, can.kicad_sch, ldo.kicad_sch, power.kicad_sch, pressure.kicad_sch, sd.kicad_sch]
2026-02-10 2nd review of schematic
    [Reggie.kicad_pcb, Reggie.kicad_sch, buck.kicad_sch, can.kicad_sch, ldo.kicad_sch, power.kicad_sch, pressure.kicad_sch, sd.kicad_sch]
2026-02-24 pcb update
    [Reggie.kicad_pcb, Reggie.kicad_sch, servo.kicad_sch]
2026-03-03 pcb and schematic update
    Found all footprints including J3, pressure controller, tvs diode. PCB infrastructure update
    [Reggie.kicad_pcb, Reggie.kicad_sch, buck.kicad_sch, pressure.kicad_sch, sd.kicad_sch, servo.kicad_sch]
2026-03-07 PCB update
    packing update
    [Reggie.kicad_pcb, Reggie.kicad_sch, Sensor_Power.kicad_sch]
2026-03-07 schematic changes and updated tvs footprints
    [Reggie.kicad_pcb, Reggie.kicad_sch, Sensor_Power.kicad_sch, buck.kicad_sch, can.kicad_sch, power.kicad_sch, pressure.kicad_sch, sd.kicad_sch]
2026-03-12 Overall Packing Complete!!
    Version1
    [Reggie.kicad_pcb]
2026-05-03 Overall Packing Backup Version
    [GPIO_Breakout.kicad_sch, Reggie.kicad_pcb, Reggie.kicad_sch]
2026-05-18 Overall Routing Complete!!!
    Version2
    [GPIO_Breakout.kicad_sch, Reggie.kicad_pcb, Reggie.kicad_sch]
2026-06-01 Routing Improvement
    Version 3. Mainly solved 3 problem: 1. clock and decoupler closer to microcontroller; 2. Route of Data+ and Data- neater; 3. wider trace for 6v and 16.8v
    [GPIO_Breakout.kicad_sch, Reggie.kicad_pcb, pressure.kicad_sch]
2026-06-03 Filled zones and via location
    Version 4. allocate filled zones and vias, also reassigned pins from microcontroller
    [GPIO_Breakout.kicad_sch, Reggie.kicad_pcb, Reggie.kicad_sch, usb.kicad_sch]
2026-06-04 via improvement and footprint allocation
    Version 4.1
    [Reggie.kicad_pcb]
2026-06-16 Version 4.2
    Rename from Reggie to Heimdall and other improvements
    [Heimdall.kicad_sch, Reggie.kicad_pcb, Reggie.kicad_sch]
2026-07-08 Version 5
    [Heimdall.kicad_pcb, Heimdall.kicad_sch, pressure.kicad_sch]
2026-07-10 tiny tweaks and ready to order
    [GPIO_Breakout.kicad_sch, Heimdall.kicad_pcb, Heimdall.kicad_sch, Sensor_Power.kicad_sch, bom.csv, buck.kicad_sch, can.kicad_sch, designators.csv]
2026-07-14 prod files after final final change
    [Heimdall.kicad_pcb, bom.csv, buck.kicad_sch, can.kicad_sch, positions.csv]
2026-08-13 initial scaffolding and removed old backups and old reggie files
    [ricpart.csv]
2026-08-13 Add notes for voltage monitoring and LED indicator
2026-08-27 Sensors & SD from kermit compiles
    [ricparts3.csv]
2026-08-27 Buck converter
2026-09-06 feat: halfabort angle and make the servo self configurting
2026-09-06 feat: Fixes to config
    [ncrgreg.cpp, nrcgreg.h, shutdown.cpp]
2026-09-27 new valve angles
2026-09-27 fix: Fixed shutdown lockup due to packet spamming
    [shutdown.cpp]
2026-09-27 fix: Proper fix for the shutdown error
    [ncrgreg.cpp, shutdown.cpp]
